Lore09/Stalker-bot/report/images/arduino.drawio.png

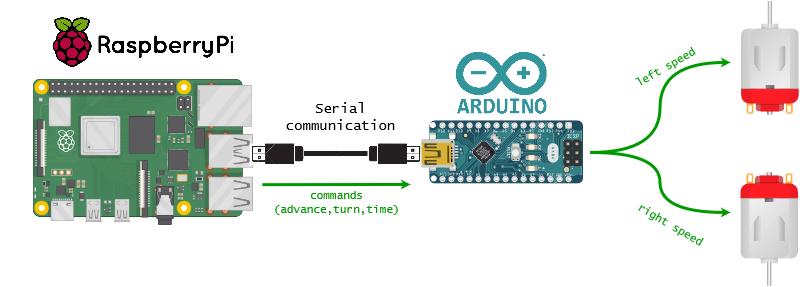
report/images/arduino.drawio.png
