Lore09/Stalker-bot/report/images/face_recognition.drawio.png

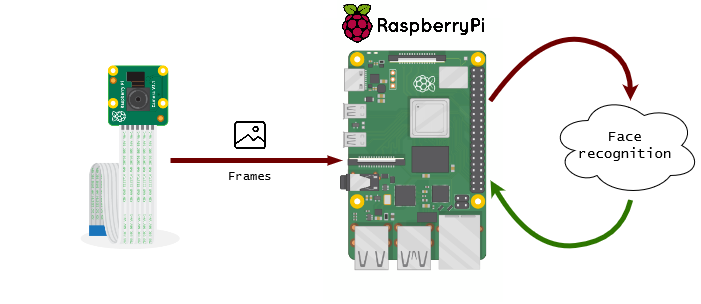
report/images/face_recognition.drawio.png
