Lore09/Stalker-bot/report/images/presentazione_circuito.png

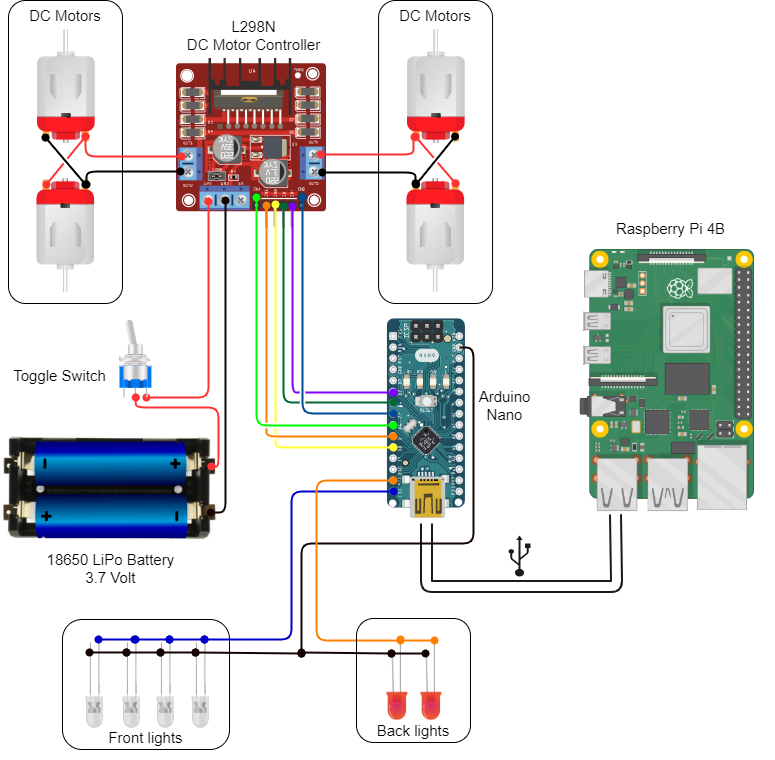
report/images/presentazione_circuito.png
