Lore09/Stalker-bot/report/images/training.drawio.png

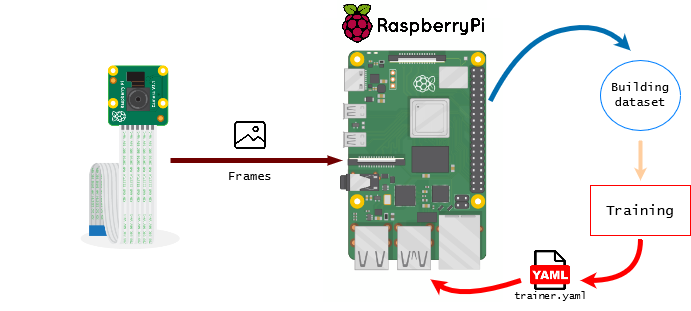
report/images/training.drawio.png
