Lore09/Stalker-bot/report/images/circuito.drawio.pdf

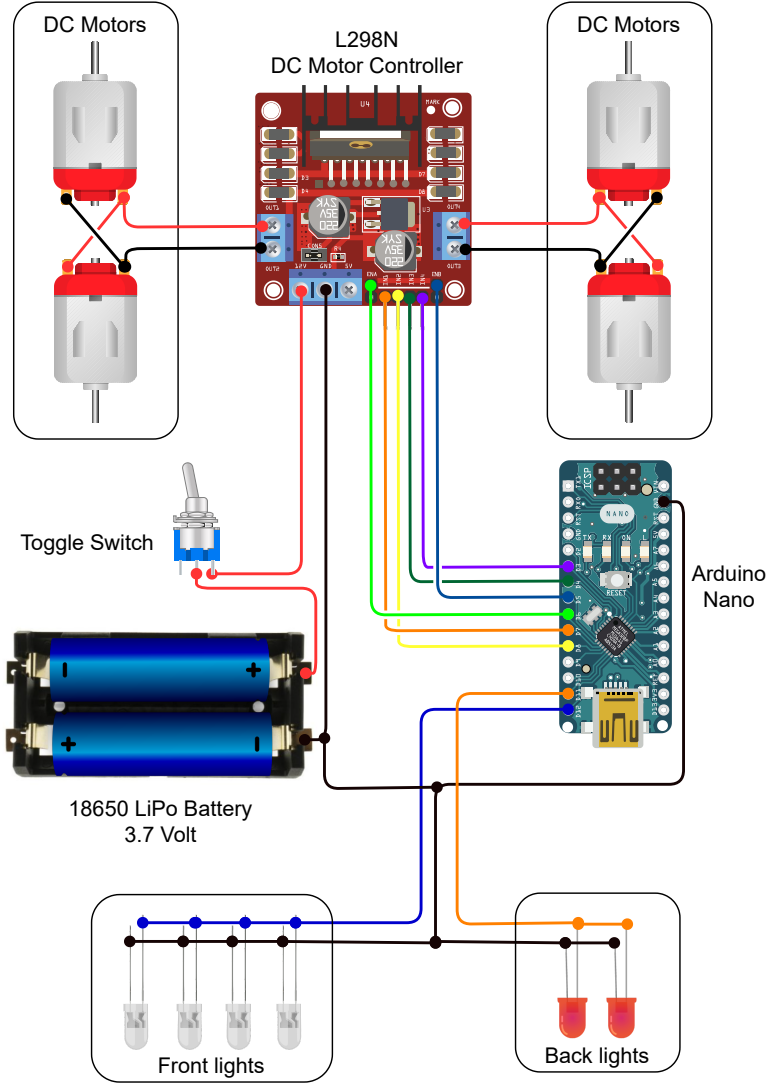
[picture p19: page 1]
18650 LiPo Battery 3.7 Volt; DC Motors; Front lights; Back lights; Arduino Nano; Toggle Switch

DC Motor Controller
