Lore09/Stalker-bot/report/images/schema.pdf

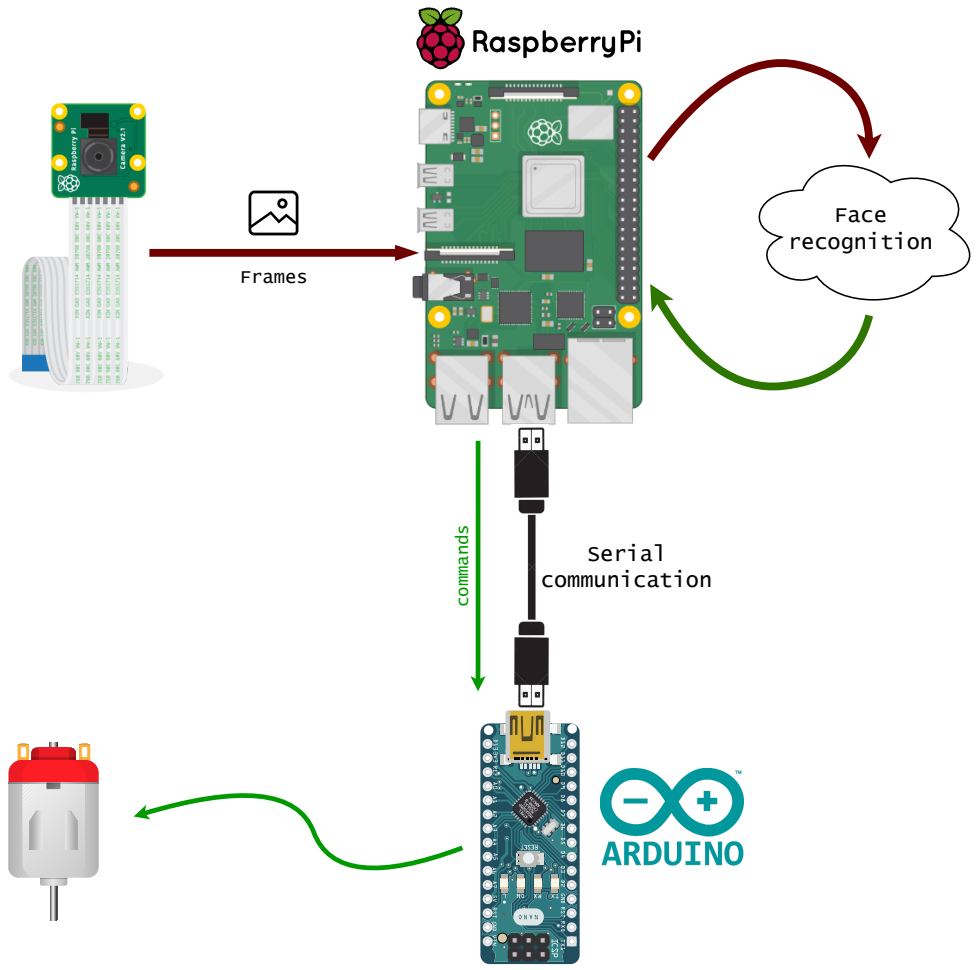
[picture p20: page 1]
Frames; Face recognition; Serial communication; commands
