Lore09/Stalker-bot/report/images/raspberry-arduino.pdf

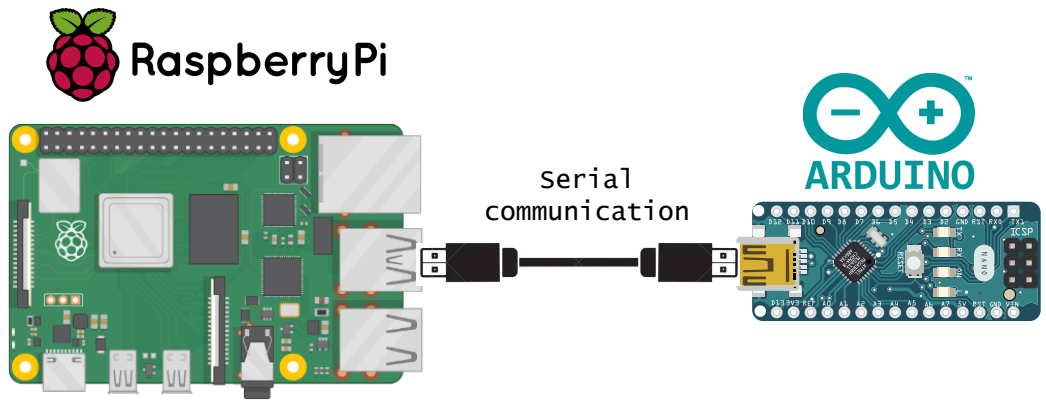
[picture p21: page 1]
Serial communication
