Lore09/Stalker-bot/Raspberry/controller.py

import pygame
import time
import serial

pygame.init()
pygame.joystick.init()

done = False

front_led = False
back_led = False

register = False
move_recorded = False

started = False

ser = serial.Serial('/dev/ttyUSB0', 9600, timeout=1)
ser.reset_input_buffer()

while not done:
    pygame.event.get()
    joystick_count = pygame.joystick.get_count()

    if joystick_count < 1:
        print('Joystick not found')
        pygame.quit()


    if not started: 
        print('%s joystick(s) found:' %joystick_count)
        for i in range(joystick_count):
            joystick = pygame.joystick.Joystick(i)
            joystick.init()
            name = joystick.get_name()
            joystick_id = joystick.get_id()
            print('Name: %s, ID: %s' %(name, joystick_id))
        started = True
        time.sleep(4)
        

    joystick = pygame.joystick.Joystick(0)
    joystick.init()
    #print(joystick.get_name())

    if joystick.get_button(0):
        front_led = not front_led
        if front_led:
            ser.write(b"F,1\n")
        else:
            ser.write(b"F,0\n")
        time.sleep(0.25)
    
    if joystick.get_button(1):
        back_led = not back_led
        if back_led:
            ser.write(b"B,1\n")
        else:
            ser.write(b"B,0\n")
        time.sleep(0.25)

    if joystick.get_button(3):
        if not register:
            command_file = open("command.txt","w")
            print("Start recording")
        else:
            command_file.close()
            print("Stop recording")
        
        register = not register
        time.sleep(1)

    if joystick.get_button(4):
        if not move_recorded:
            command_file = open("command.txt","r")
            print("Starting recorded movements")
        else:
            command_file.close()
        
        move_recorded = not move_recorded
        time.sleep(1)

    if move_recorded:
        string = command_file.readline()
        if string == "":
            move_recorded = False
        else:
            ser.write(string.encode('utf-8'))
    else:
        x = -int(joystick.get_axis(0)*50)
        y = -int(joystick.get_axis(1)*100)
        string = str(y) + "," + str(x) + ",100\n"
        ser.write(string.encode('utf-8'))

        if register:
            command_file.write(string)

    print(string)
    time.sleep(0.05)
