Lore09/Stalker-bot/Raspberry/train_faces.py

import cv2
import os
import numpy as np
from PIL import Image

cam = cv2.VideoCapture(0)
cam.set(3, 640)  # set video width
cam.set(4, 480)  # set video height

detector = cv2.CascadeClassifier('classifier/haarcascade_frontalface_default.xml')

while True:

    # For each person, enter one numeric face id
    face_id = input('\n enter user id end press <return> ==>  ')

    print("\n [INFO] Initializing face capture. Look the camera and wait ...")
    # Initialize individual sampling face count
    count = 0
    response = ""

    if not os.path.exists("dataset"):
        os.mkdir("dataset")

    while True:

        ret, img = cam.read()
        # img = cv2.flip(img, -1) # flip video image vertically
        gray = cv2.cvtColor(img, cv2.COLOR_BGR2GRAY)
        faces = detector.detectMultiScale(gray, 1.3, 5)

        for (x, y, w, h) in faces:
            cv2.rectangle(img, (x, y), (x + w, y + h), (255, 0, 0), 2)
            count += 1

            # Save the captured image into the datasets folder
            cv2.imwrite("dataset/User." + str(face_id) + '.' + str(count) + ".jpg", gray[y:y + h, x:x + w])

            cv2.imshow('image', img)

        k = cv2.waitKey(100) & 0xff  # Press 'ESC' for exiting video
        if k == 27:
            break
        elif count >= 30:  # Take 30 face sample and stop video
            break
    cam.release()
    cv2.destroyAllWindows()

    while response != "n" and response != "y":
        response = input("\nDo you want to record another face? (y/n) ==>  ")

    if response == "n":
        break

# Do a bit of cleanup
print("\n [INFO] Cleanup\n")

# --------------TRAINING---------------------

print("[INFO] Starting training\n")
# Path for face image database
path = 'dataset'

recognizer = cv2.face.LBPHFaceRecognizer_create()


def getImagesAndLabels(path):
    imagePaths = [os.path.join(path, f) for f in os.listdir(path)]
    faceSamples = []
    ids = []

    for imagePath in imagePaths:

        PIL_img = Image.open(imagePath).convert('L')  # convert it to grayscale
        img_numpy = np.array(PIL_img, 'uint8')

        id = int(os.path.split(imagePath)[-1].split(".")[1])
        faces = detector.detectMultiScale(img_numpy)

        for (x, y, w, h) in faces:
            faceSamples.append(img_numpy[y:y + h, x:x + w])
            ids.append(id)

    return faceSamples, ids

print ("\n [INFO] Training faces. It will take a few seconds. Wait ...")
faces,ids = getImagesAndLabels(path)
recognizer.train(faces, np.array(ids))

# Save the model into trainer/trainer.yml
recognizer.write( path + '/trainer.yml') # recognizer.save() worked on Mac, but not on Pi

# Print the numer of faces trained and end program
print("\n [INFO] {0} faces trained. Exiting Program".format(len(np.unique(ids))))
