Lore09/Stalker-bot/(commit log)

2023-04-17 raspberry test
2023-05-02 Project refactor: - uniti dataset e train in train_faces.py - spostato il progetto in Raspberry
2023-05-02 Arduino project
2023-05-07 arduino map
2023-05-26 Led command
2023-06-08 Frame normalization
